asdfgh0318/RadioMicroscope/1.md

# Original Prompt — RadioMicroscope v2

> redo this thing from scratch wih next gen in mind be able to source parts from poland and achieve great allaround featurres move everything to archive use 1.md research repo first

Saved verbatim, 2026-11-11. The v1 prototype this refers to is in [`archive/v1/`](archive/v1/).
