asdfgh0318/RadioMicroscope/papers/antennas/D_3ds_cst_learning_edition.md

# CST STUDIO SUITE Learning Edition

**Complete Technology for 3D Electromagnetics**

## The CST Studio Suite Learning Edition is available free of charge to students, educators and researchers of personal and educational use

The CST Studio Suite Learning Edition introduces you to the world of electromagnetic simulation, making Maxwell’s equations easier to understand than ever. With this free edition you have - bar some restrictions - access to our powerful visualization engine and some of the most advanced solvers of CST Studio Suite, making it ideal for use as part of coursework as well as for anyone wishing to become more proficient with CST Studio Suite. You can download the CST Studio Suite Learning Edition free of charge from the SIMULIA Community.

### **Join the SIMULIA Community,** it's free!

[](/media/9399)

[   https://youtu.be/Z0qi5\_Alm8c
 1 minute     ](https://youtu.be/Z0qi5_Alm8c)

Simply log in with your 3DEXPERIENCE ID username and password. If you do not already have a 3DEXPERIENCE ID, you can register now . An account is free and access is instant.

The SIMULIA Community is our user forum for all those interested in simulation of structures, fluids or electromagnetic fields. You can discuss simulation with your peers, find the latest resources on SIMULIA simulation technology, get insights from experts and select from a large range of e-seminars to deepen your knowledge.

To accompany the CST Studio Suite Learning Edition, we have prepared some examples, which are typical of the type of textbook problems you may encounter during your studies of electromagnetic theory or other related courses. Each tutorial includes descriptive text, a CST Studio Suite file, and also a short video showing how to construct each of the models. These examples are available in the SIMULIA Community.

 CST Tutorials> Dassault Systèmes (https://www.3ds.com/assets/invest/2023-03/edu-cst-tutorials.jpg)

## CST Studio Suite Tutorials

\<!--td {border: 1px solid #cccccc;}br {mso-data-placement:same-cell;}-->
\<!--td {border: 1px solid #cccccc;}br {mso-data-placement:same-cell;}-->
\<!--td {border: 1px solid #cccccc;}br {mso-data-placement:same-cell;}-->
To get started, CST Studio Suite Tutorials are available here

[Discover](https://r1132100503382-eu1-3dswym.3dexperience.3ds.com/#community:39/wiki:13_mFrlJTnmMB6fVWqzDkw)

 CST Installation> Dassault Systèmes (https://www.3ds.com/assets/invest/2023-03/edu-cst-install.jpg)

## CST Studio Suite Install instructions

\<!--td {border: 1px solid #cccccc;}br {mso-data-placement:same-cell;}-->
\<!--td {border: 1px solid #cccccc;}br {mso-data-placement:same-cell;}-->
CST Studio Suite Learning Edition Installation Instructions

[Download](https://r1132100503382-eu1-3dswym.3dexperience.3ds.com/#community:39/media:Cq90wV9kR2adsF6Hak7Wpw)

## System requirements

CST Studio Suite is available for modern Windows operating systems. Please refer to the installation guide for more information.

## Download Issues

For download and installations issues only (no support for CST Studio Suite), please use the **[community](https://r1132100503382-eu1-3dswym.3dexperience.3ds.com/#community:39)** to contact us

## OTHER SOLUTIONS AVAILABLE

Discover our full panel of solutions available, the choice is yours!
*Login can be required for some solutions.*

## SOLIDWORKS xDesign for Students

100% cloud design and engineering apps to upskill and land your dream job – From any device.

[Edu-SW-Cloudapps-stu](/media/8403)

[Learn more](/edu/education/students/solutions/solidworks-3dx)

STUDENT OFFER

## CATIA Mechanical for Students

Take your design, engineering &amp; sophisticated mechanical projects to the next level!

[Edu-3DX-Catia-stu-576x488](/media/8681)

[Learn more](/edu/education/students/solutions/catia-3dx)

STUDENT OFFER

## 3DEXPERIENCE ENGINEER for Students

The most complete and advanced design-to-manufacture package.

[Edu-3DX-Engineer-stu-576x488](/media/8682)

[Learn more](/edu/education/students/solutions/engineer-3dx)

STUDENT OFFER

## Abaqus Learning Edition

Complete solution for realistic simulation.
Available free of charge for personal and educational use.

[Edu-leg-Abaqus-stu-424x500](/media/8683)

[Discover](/edu/education/students/solutions/abaqus-le)

LEARNING EDITION

## CST Studio Suite Learning Edition

Complete Technology for 3D Electromagnetics.
Available free of charge for personal and educational use.

[Edu-leg-CST-stu-424x500](/media/8685)

[Discover](/edu/education/students/solutions/cst-le)

LEARNING EDITION

## Antenna Magus Learning Edition

The Leading Antenna Design Tool.
Available free of charge for personal and educational use.

[Edu-leg-Antenna-stu-424x500](/media/8684)

[Discover](/edu/education/students/solutions/antenna-magus-le)

LEARNING EDITION

## ICEM Surf Learning Edition

The Art of Surface Modelling
Free download

[Edu ICEM Surf Learning Edition solution](/media/18276)

[Discover](/edu/education/students/solutions/icem-surf)

LEARNING EDITION

## SOLIDWORKS Desktop

Proven and Powerful SOLIDWORKS 3D CAD, **available for free**

[Edu Solidworks desktop solution student ](/media/22171)

[Discover](https://www.solidworks.com/product/students/design-standard-form)

STUDENT EDITION

## HomeByMe

Free and easy-to-use online software to design and decorate your home in 3D.

[Edu-leg-Homebyme-stu-424x500](/media/8686)

[Discover](https://home.by.me/)

FREE ONLINE

 CST Studio Suite LE hero banner> Dassault Systèmes

[  Download for free     ](https://r1132100503382-eu1-3dswym.3dexperience.3ds.com/#community:39/wiki:_NXifU43Q7yHzTiCX9yEaw)

Solutions
