asdfgh0318/RadioMicroscope/papers/antennas/D_gh_ICDT-Inatel-Cubesat-Design-Team_S-Band-Antenna_README.md

<div align="center">
  ICDT Logo
</div>
<h1 align="center">S-Band RHCP 2.45 GHz Antenna</h1>

<p align="center">
    
    
    
    
    
</p>

<p align="center">
    <a href="#overview">Overview</a> •
    <a href="#repository-organization">Repository Organization</a> •
    <a href="#releases">Releases</a> •
    <a href="#references">References</a> •
    <a href="#license">License</a>
</p>

## Overview
This project involves the development of an S-band antenna tailored for a 1U CubeSat platform. The system is engineered to handle both uplink and downlink capabilities using LoRa technology, specifically optimized for integration with the E80-900M2213S module.

<p align="center">
    &nbsp;&nbsp;&nbsp;
</p>

**Technical Parameters**
- Center Frequency: 2.45 GHz
- Axial Ratio Bandwidth: 14 MHz (2443 – 2457 MHz for AR < 3 dB)
- Peak Realized Gain: 7.58 dBi
- Polarization: Right-Hand Circular Polarization (RHCP)
- Connector Type: Right-Angle SMA

## Repository Organization

* `docs`: Technical documentation and datasheets.
* `hardware`: Core hardware files.
    * `3D`: 3D models (.step).
    * `Fabrication`: BOM and Gerber files for JLCPCB manufacturing.
    * `PCB`: KiCad schematics and layout design.
* `simulation`: Ansys HFSS simulation and data files.

## Releases

<table>
  <thead>
    <tr>
      <th>Render</th>
      <th>Board Name</th>
      <th>Status</th>
      <th>Latest Release</th>
      <th>Date</th>
      <th>Datasheet</th>
      <th>BOM</th>
      <th>Ordering Info</th>
    </tr>
  </thead>
  <tbody>
    <tr>
      <td>render</td>
      <td>S-Band Antenna v1</td>
      <td>🧪 Testing</td>
      <td><a href="https://github.com/ICDT-Inatel-Cubesat-Design-Team/S-Band-Antenna/releases/tag/v1.0">v1.0</a></td>
      <td>05-06-2026</td>
      <td><a href="docs/Datasheet S-Band RHCP 2.45 GHz Antenna.pdf">PDF</a></td>
      <td>Yes</td>
      <td><a href="hardware/Fabrication/GERBER-Antenna.zip">GERBER</a> (JLCPCB)</td>
    </tr>
  </tbody>
</table>

## References

This project was based on the SpaceLab UFSC [S-Band Antenna Project](https://github.com/spacelab-ufsc/sband-antenna/), with special thanks to [Lucas Ryan](https://github.com/SPHINXLRC) (SpaceLab) and [Yunior Alcantara](https://github.com/yag0x1) (SpaceLab) for their assistance with the SMA connectors.

**Missions Associated with this Project**

<p>
  
  
  
<p>

## License

This project is licensed under the permissive, weakly-reciprocal **[CERN-OHL-W-2.0](LICENSE)** open-hardware license. You are free to modify and distribute these files, provided downstream hardware design modifications remain under the same terms.
