asdfgh0318/RadioMicroscope/papers/antennas/EXTRACTS.md

# EXTRACTS — antenna research for the radio microscope (merged A + B + C + D)

Merged 2026-11-11 from `_EXTRACTS_A.md` (beam theory, sampling, polarisation, calibration, rotary joints),
`_EXTRACTS_B.md` (DIY designs, RF switches), `_EXTRACTS_C.md` (ready-made antennas, prices, pigtails) and
`_EXTRACTS_D.md` (PCB fab cost, FR4 loss, open designs, simulators, cable/connector losses). The part files are
left in place and are the authoritative copies; this file is their concatenation, unchanged except for this
header and the quote-check record at the end. Every quote is verbatim from a file saved in this folder.
Evidence tags: [V] read at source in the saved file; [S] search snippet only (no claim rests on it).

<!-- ===================== part A (from _EXTRACTS_A.md) ===================== -->

# Extracts, part A: beam theory for a mapper, calibration, rotary joints

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

---

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

---

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

<!-- ===================== part B (from _EXTRACTS_B.md) ===================== -->

# Extracts — fork B (Q2 DIY designs, Q3 dual-band / RF switch)

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

---

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

> "The gain at 2400.000 MHz was recorded at 7.22 dBi." (p.6, §4.2)

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

---

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

---

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

---

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

---

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

---

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

---

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

---

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

---

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

---

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

<!-- ===================== part C (from _EXTRACTS_C.md) ===================== -->

# Extracts C: ready-made lightweight directional antennas (question 4)

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

---

## 5.8 GHz, circular polarisation (FPV)

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

## 5.8 GHz, linear polarisation

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

## 2.4 GHz

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

## Dual-band 2.4 + 5 GHz

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

## Pigtails (U.FL / IPEX-1 to SMA / RP-SMA), Poland

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

---

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

<!-- ===================== part D (from _EXTRACTS_D.md) ===================== -->

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

---

## D-1. PCB fabrication cost and delivery to Poland

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

---

## D-2. FR4 dielectric loss and what it costs in gain

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

---

## D-3. Open antenna designs with a licence

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

---

## D-4. Free simulators

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

---

## D-5. Feed cable and connector losses (closes the part-D gap and task 2)

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

---

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

---

## Quote-check record (2026-11-11)
40 quotes from parts A, B and C (about 13 per part, including prices read from JSON-LD) were re-checked against
the saved .txt/.html files with whitespace-normalised string search. All 40 match in substance. Differences found
are layout artefacts only: pdftotext line/column breaks (A4 Ford, A6 Mangum, A13 Wunderlich p.59, B15 QEX helix,
B16 Radioeng), the "observaAons" ligature already noted in A4, and a curly apostrophe ("shouldn’t") printed
straight in A6. No quote was found that changes a number or the meaning of its source.
Quotes written for part D were checked the same way (41 checked; one capitalisation slip, "Near-Field", corrected).
