asdfgh0318/RadioMicroscope/papers/extra-sensors/EXTRACTS.md

# EXTRACTS - extra sensors (2026-11-11)

Quotes are verbatim (whitespace-collapsed) from the saved local files; checked programmatically.

## Hi-Link HLK-LD2450 manual (via elemon mirror) https://www.elemon.com.ar/images/productos/hojas-de-datos/radar-modulos/hlk-ld2450.pdf
Local file: `ld2450.pdf`

- "Precise motion target localization and tracking"
- "Longest detection range 6m"
- "Azimuth angle ±60°, pitch angle ±35°"
- "256000, with 1 stop bit and no parity bit."
- "Ultra-small module size: 15mm x 44mm"

## ST VL53L5CX datasheet https://cdn.sparkfun.com/assets/6/e/3/0/6/vl53l5cx-datasheet.pdf
Local file: `vl53l5cx.pdf`

- "Time-of-Flight 8x8 multizone ranging sensor with wide field of view"
- "Up to 400 cm ranging"
- "I2C: 400 kHz to 1 MHz serial bus, address: 0x52"

## Melexis MLX90640 datasheet https://www.melexis.com/-/media/files/documents/datasheets/mlx90640-datasheet-melexis.pdf
Local file: `mlx90640.pdf`

- "Small size, low cost 32x24 pixels IR array"
- "2 FOV options – 55°x35° and 110°x75°"
- "Programmable refresh rate 0.5Hz…64Hz"

## Panasonic Grid-EYE AMG88 spec (Adafruit mirror)
Local file: `amg8833.pdf`

- "Pixel number 64（8×8 Matrix）"
- "Typ.60°（Horizontal, Vertical)"

## ESPHome LD2410 page https://esphome.io/components/sensor/ld2410/
Local file: `esphome_ld2410.html`

- "The ld2410 sensor platform allows you to use HI-LINK LD2410 motion and presence sensors with ESPHome."

## ESPHome LD2450 page https://esphome.io/components/sensor/ld2450/
Local file: `esphome_ld2450.html`

- "enabling measurement of the target’s distance, angle and speed (relative to the sensor)"

## Botland TF-Luna 99,00 PLN InStock https://botland.com.pl/czujniki-time-of-flight/16638-laserowy-czujnik-odleglosci-lidar-tf-luna-8m-uarti2c-5903351249041.html
Local file: `botland_tfluna.html`

- "Komunikacja: UART / I2C"
- "Zakres pracy: od 0,2 m do 8 m (współczynnik odbicia 90%)"
- "Kąt widzenia FoV: 2°"
- "Częstotliwość: 100 Hz"

## Botland Seeed Human Static Presence 24GHz 24,90 PLN InStock (page id 24129)
Local file: `botland_seeed_mr24.html`

- "Interfejs: GPIO (poziom IO 3,3 V), UART"
- "Zasięg wykrywania: od 0,75 m do 6 m (regulowany)"

## Botland DFRobot C4001 59,90 PLN InStock (id 25320)
Local file: `botland_c4001.html`

- "zapewniający zasięg do 12 metrów"
- "Obsługuje interfejs Gravity oraz komunikację I2C i UART"
- "Pomiar prędkości : umożliwia detekcję prędkości od 0,1 m/s do 10 m/s"

## msalamon HLK-LD2410B 33,19 PLN, 21 in stock https://sklep.msalamon.pl/produkt/hlk-ld2410b-czujnik-obecnosci-czlowieka-24ghz/ (LD2410C 28,09 PLN page shows OutOfStock)
Local file: `msal_ld2410b.html`

- "maksymalnym zasięgu wykrywania do 6 metrów"
- "Napięcie zasilania wynosi 5V"

## msalamon CDM324 28,99 PLN InStock
Local file: `msal_cdm324.html`

- "Radar Dopplera CDM324"

## Botland reSpeaker XVF3800 269,00 PLN OutOfStock (id 28171)
Local file: `botland_xvf3800.html`

- "umożliwia precyzyjne wykrywanie kierunku źródła dźwięku (DoA)"

## Seeed XVF3800 wiki https://wiki.seeedstudio.com/respeaker_xvf3800_introduction/
Local file: `xvf3800_wiki.html`

- "featuring AEC, AGC, DoA, beamforming"

## Botland M5Stamp ESP32-P4 63,90 PLN InStock (id 28729)
Local file: `botland_p4stamp.html`

- "interfejsy MIPI CSI i MIPI DSI"

## Espressif ESP32-P4 datasheet https://www.espressif.com/sites/default/files/documentation/esp32-p4_datasheet_en.pdf
Local file: `esp32p4_datasheet.pdf`

- "– MIPI CSI"

## espressif/esp32-camera README (raw.githubusercontent)
Local file: `esp32cam_readme.md`

- "### Autofocus (OV5640)"
- "OV5640 autofocus relies on loading an internal firmware blob over SCCB during `esp_camera_af_init()`."

## Botland Grove AS3935 139,00 PLN InStock (id 23887)
Local file: `botland_as3935.html`

- "w promieniu do 40 km"
- "Komunikuje się za pośrednictwem interfejsu I2C lub SPI"

## Botland M5Stack GPS/BDS Unit AT6668 61,90 PLN InStock (id 26079)
Local file: `botland_m5_gps_at6668.html`

- "Częstotliwość aktualizacji pozycji: do 10 Hz"
- "Interfejs komunikacyjny: UART (115200 bps przy 8N1)"

## Botland Waveshare Thermal Camera HAT 80x62 389,00 PLN InStock (id 23877)
Local file: `botland_thermal_hat_waveshare.html`

- "80x62px, 45 FOV"
- "maksymalnej szybkości 25 klatek na sekundę (FPS)"

## Seeed XIAO ESP32-S3 wiki https://wiki.seeedstudio.com/xiao_esp32s3_getting_started/
Local file: `xiao_s3_wiki.html`

- "D4 Analog, SDA GPIO5"
- "D6 TX GPIO43 GPIO, UART Transmit"
- "Digital microphone_CLK GPIO42 PDM clock pin for MIC"
- "Onboard SD Card_SCK GPIO7"

## CNX Software 2026-10-04 ESP-SDR article (saved earlier in papers/sdr)
Local file: `cnx-esp-sdr.txt (in ../sdr)`

- "Supported chips – ESP32, ESP32-C3, ESP32-C5 (dual-band 2.4/5 GHz)"
- "ESP-WebSDR captures short I/Q snapshots to build the spectrum and waterfall"
- "The original ESPARGOS firmware remains receive-only."

## Prices read from product page data (PLN gross; shop; stock as page shows)
- Botland: VL53L5CX Pololu 3417 69,90 OutOfStock; VL53L7CX Pololu 3418 89,90; VL53L5CX SparkFun SEN-19013 149,90 InStock; VL53L1X Pololu 81,90 InStock; M5 ToF4M VL53L1X 52,90 InStock; TF-Luna 99,00 InStock; TFmini-S 199,00 InStock; TFmini Plus 219,00 (list); LD19 DTOF 360 DFRobot SEN0547 599,00 InStock
- Botland thermal: MLX90641 16x12 Waveshare 249,00 OutOfStock; Waveshare Thermal HAT 80x62 389,00; M5Stick T-Lite (MLX90640) 439,00 InStock; UNI-T UTi260B 256x192 1299,00 InStock. Adafruit MLX90640 4469 on botland.store 'temporarily unavailable' (EUR, not PLN).
- Botland radar: S3KM1110 Waveshare 12,90 OutOfStock; Seeed Human Static Presence 24,90 InStock; DFRobot C4001 59,90 InStock; DFRobot SEN0395 142,00; Grove BGT24LTR11 349,00
- msalamon: HLK-LD2410B 33,19 InStock (21 pcs); HLK-LD2410C 28,09 OutOfStock; CDM324 28,99 InStock; ESP32-CAM 42,69 InStock; ATGM336H GPS 32,59 InStock; INMP441 37,19 InStock; ESP32-S3-EYE 358,19
- Gotronik: INMP441 12,00 (itemprop price; ships 24 h)
- Botland audio/cam: ICS43434 Adafruit 47,90 InStock; SPH0645 39,80; XVF3800 269,00 OutOfStock; ReSpeaker Mic Array v2.0 259,00; XIAO ESP32-S3 Sense 79,90 OutOfStock; DFR1154 ESP32-S3 OV3660 109,00 InStock; M5 CamS3 5MPx 89,90 InStock; ESP32-CAM Joy-IT 54,90; M5Stamp ESP32-P4 63,90 InStock; ESP32-P4-Function-EV 439,00 OutOfStock
- Botland other: QMC5883L GY-271 29,90 InStock; MMC5603 Adafruit 31,90; BMM150 Waveshare 27,90; AS7341 Waveshare 75,90; Grove AS3935 139,00; Geiger DFRobot 289,00 / Joy-it 299,00; LC29H L1+L5 GNSS HAT 199,00; M5 GPS AT6668 61,90

## Could not retrieve / not verified
- LD2450, MLX90640 (bare), AMG8833, RD-03D/E, LD2420, LD2461, MR60BHA2, BGT60, HLK-LD2450 PLN price: no Polish shop page found/opened (kamami.pl/tme.eu return 403) - no PLN price claimed.
- TF-Luna, TFmini-S, LD19, INMP441, ICS43434, AS3935, QMC5883L, RM3100, MMC5983MA, OV5640 module, Waveshare S3KM1110 manuals: only shop/vendor page text (not datasheet PDFs) read. Shop-page specs, tier [S]/shop.
- GNSS raw data (UBX RAWX) on ATGM336H/AT6668: not verified.
- InfiRay P2, Topdon TC001, HTPA, Infineon BGT60, Seeed MR60BHA2: not researched.
