asdfgh0318/RadioMicroscope/docs/notes-1.jpeg

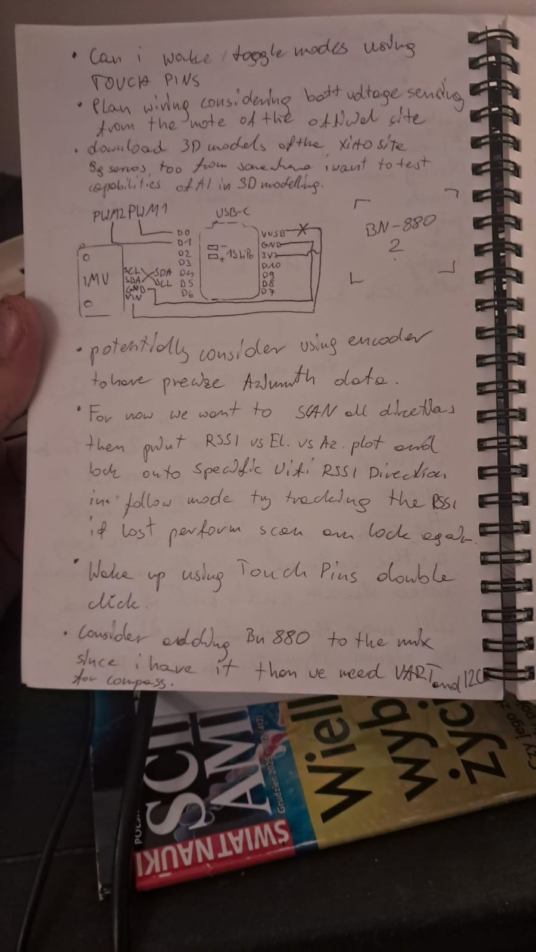
docs/notes-1.jpeg
