asdfgh0318/RadioMicroscope/docs/notes-2.jpeg

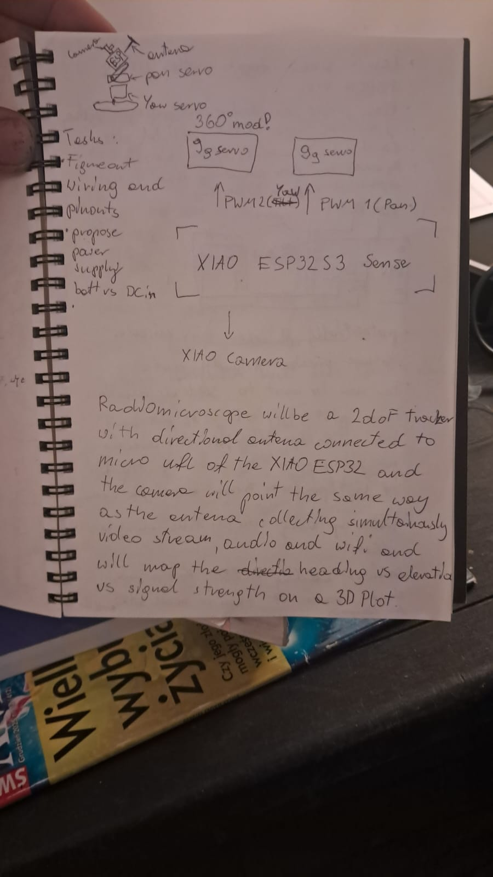
docs/notes-2.jpeg
