asdfgh0318/RadioMicroscope/docs/prototype.jpeg

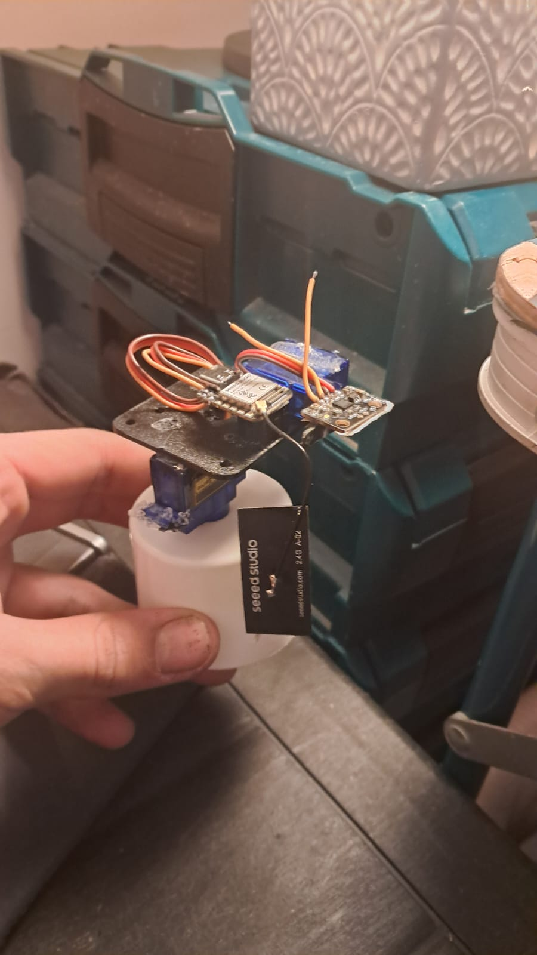
docs/prototype.jpeg
