asdfgh0318/RadioMicroscope/docs/sourcing.md

# Polish sourcing: listings checked on 2026-11-11

Raw results of the shop checks behind the parts list. Prices are gross PLN as shown on the day.

**How to read the "checked" column**

- **page** — the shop's own product page was opened and the price and stock read from it.
- **listing** — the shop's own search/category listing was read, not the product page.
- **snippet** — seen only through a search snippet or a price aggregator (elecena.pl, Ceneo). Treat price and stock as unconfirmed.
- **maker** — manufacturer's page with a recommended price; no shop found.

Kamami and Allegro refused automated access (HTTP 403), so nothing from them is better than "snippet". TME opened only partly. Batna24, Wispro, ElectroPark and Nettigo could not be searched.

## Motion

| Item | Shop | PLN | Stock on the day | Checked |
|---|---|---|---|---|
| Waveshare ST3215 bus servo, 30 kg·cm, 12-bit magnetic encoder, 6–12.6 V | [Botland](https://botland.com.pl/serwa-praca-ciagla-360/21963-30kg-serial-bus-servo-serwomechanizm-z-enkoderem-magnetycznym-360-stopni-waveshare-22414.html) | 109.00 | none; 86 due 20.11.2026 | page |
| Waveshare ST3215-HS, 20 kg·cm, 106 rpm, same bus | [Botland](https://botland.com.pl/serwa-praca-ciagla-360/23725-20kg-bus-servo-motor-serwomechanizm-z-enkoderem-magnetycznym-360-stopni-waveshare-25127.html) | 105.00 | 38 | page |
| Waveshare ST3020, 25 kg·cm | [Botland](https://botland.com.pl/serwa-praca-ciagla-360/23726-st3020-25kg-serial-bus-servo-serwomechanizm-uart-waveshare-24703.html) | 115.00 | 17 | page |
| Waveshare SC09, 2.3 kg·cm, potentiometer 1024 steps, 300° | [Botland](https://botland.com.pl/serwa-praca-ciagla-360/23561-sc09-23kg-serial-bus-servo-serwomechanizm-uart-waveshare-24440.html) | 45.90 | none; 100 due 18.12.2026 | page |
| Waveshare ST3215 7.4 V version | Kamami | 93.33 | unknown | snippet |
| Bus Servo Adapter (A), UART + USB-C | [Botland](https://botland.com.pl/sterowniki-serw/24907-bus-servo-adapter-a-sterownik-do-serwomechanizmow-magistrali-szeregowej-serii-stsc-uart-waveshare-25514-5904422385736.ht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) | 19.90 | none; 48 due 04.12.2026 | page |
| Bus Servo Adapter (A) | Kamami | ~21.17 | unknown | snippet |
| Waveshare Servo Driver with ESP32 | [Botland](https://botland.com.pl/sterowniki-serw/21964-esp32-servo-driver-expansion-board-sterownik-do-serwomechanizmow-uart-wifi-bluetooth-waveshare-21593.html) | 69.90 | 9 | page |
| Waveshare 2-axis pan-tilt camera module (ST3215, pan ±180°, tilt −45…+90°) | Kamami | 531.62 | unknown | snippet |
| Slip ring 6 wires × 2 A, 22 mm, 300 rpm | [Botland](https://botland.com.pl/zlacza-slizgowe/7143-pierscien-slizgowy-6-przewodowy-2a-22mm-5904422335533.html) | 67.00 | 41 | page |
| Slip ring 12 wires × 2 A, 22 mm | [Botland](https://botland.com.pl/zlacza-slizgowe/7145-pierscien-slizgowy-12-przewodowy-2a-22mm-5904422335540.html) | 84.90 | 36 | page |
| NEMA17 JK42HS40-1704, 0.4 N·m | [Botland](https://botland.com.pl/silniki-krokowe/6429-silnik-krokowy-jk42hs40-1704-200-krokowobr-28v17a04nm-5904422334635.html) | 69.00 | 29 | page |
| TMC2209 driver (BigTreeTech v1.3) | [Botland](https://botland.com.pl/stepstick-sterowniki-do-silnikow-krokowych/19883-sterownik-silnika-krokowego-bigtreetech-tmc2209-v13-5904422379667.html) | 27.90 | 200 | page |
| TMC2209 stepstick | [MSX](https://sklep.msalamon.pl/produkt/sterownik-silnika-krokowego-tmc2209/) | 21.79 | 28 | page |
| AS5600 12-bit magnetic encoder with magnet | [MSX](https://sklep.msalamon.pl/produkt/as5600-enkoder-magnetyczny-12-bit/) | 11.19 | 76 | page |
| Steel turntable bearing 155 × 155 mm | [ABC-RC](https://abc-rc.pl/pl/products/obrotnica-meblowa-obrot-360-155x155mm-lozysko-obrotowe-fotela-stolu-21908.html) | 18.20 | yes | page |

Notes: Botland's ST3215 page gives no baud rate and a wrong weight (the Kamami snippet says 69 g). Stall current is 2.7 A (ST3215) and 2.4 A (ST3215-HS) per the pages. No slip ring with a through-bore was found at retail.

## Brushless direct drive

| Item | Shop | PLN | Stock on the day | Checked |
|---|---|---|---|---|
| SimpleFOC Mini driver (DRV8313), 8–30 V, 2.5 A per channel, 3.3 or 5 V logic (page re-read later the same day) | [Gotronik](https://www.gotronik.pl/modul-sterownika-silnika-simplefoc-mini-na-ukladziedrv8313-p-14252.html) | 25.00 | in stock | page |
| SimpleFOCMini DRV8313, 8–30 V, 2.5 A | [Gotronik](https://www.gotronik.pl/modul-sterownika-silnika-bezszczotkowego-dc-simplefocmini-foc-drv8313-p-12826.html) | 36.00 | out of stock | page |
| Dual-channel DRV8313 driver | [Gotronik](https://www.gotronik.pl/modul-dwukanalowego-sterownika-silnika-bezszczotkowego-bldc-drv8313-p-12830.html) | 47.00 | out of stock | page |
| ESP32 FOC 20 A board | [Gotronik](https://www.gotronik.pl/modul-sterownika-silnika-bezszczotkowego-esp32-foc-20a-wifi-bluetooth-p-12828.html) | 99.00 | in stock | page |
| Makerbase MKS ESP32 FOC, dual channel | Kamami | 149.90 | unclear | snippet |
| AS5600 encoder with magnet | [MSX](https://sklep.msalamon.pl/produkt/as5600-enkoder-magnetyczny-12-bit/) | 11.19 | 76 | page |
| MT6701 encoder, 14-bit, magnet included | [MSX](https://sklep.msalamon.pl/produkt/mt6701-magnetyczny-enkoder/) | 15.19 | out of stock | page |
| Gimbal motor, no-name 2208 80T / 90 KV | Allegro | ~64–86 | unknown | snippet |
| T-Motor GB2208 | Allegro (archived listing) | ~99.86 | unknown | snippet |
| M5Stack RollerCAN: motor + FOC driver + encoder + slip ring in one, 0.065 N·m at 16 V, 84 g | [Botland](https://botland.com.pl/moduly-unit-moduly-rozszerzen/26016-rollercan-unit-silnik-bezszczotkowy-ze-sterownikiem-stm32-modul-rozszerzen-unit-m5stack-u188-6972934175687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) | 239.00 | in stock | page |
| M5Stack Roller485 (same, RS-485) | [Botland](https://botland.com.pl/moduly-unit-moduly-rozszerzen/26021-roller485-unit-silnik-bezszczotkowy-ze-sterownikiem-stm32-modul-rozszerzen-unit-m5stack-u182-6972934175533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) | 229.00 | in stock | listing |

Notes: no dedicated gimbal motor (iPower GM/GBM, T-Motor GB) was found at any Polish shop whose pages opened; the only sightings are Allegro marketplace snippets. No BaseCam or Storm32 gimbal controller and no AS5048A breakout were found at a regular shop.

## Controllers, radios and sensors

| Item | Shop | PLN | Stock on the day | Checked |
|---|---|---|---|---|
| Seeed XIAO ESP32-C5: 2.4 + 5 GHz Wi-Fi 6, U.FL socket, 8 MB flash, 8 MB PSRAM | [Botland](https://botland.com.pl/xiao/28890-seeed-xiao-esp32-c5-wifibluetoothzigbeethreadmatter-seeedstudio-100010048-5902186335752.html) | 30.90 | orderable; no further delivery planned | page |
| Seeed XIAO ESP32-S3 Sense (camera, microphone, microSD) | [Botland](https://botland.com.pl/xiao/22926-seeed-xiao-esp32-s3-sense-zestaw-z-kamera-ov3660-wifibluetooth-seeedstudio-113991115.html) | 79.90 | none; about 31.12.2026 | page |
| Seeed XIAO ESP32-S3 (no camera) | [Botland](https://botland.com.pl/xiao/22878-seeed-xiao-esp32-s3-wifibluetooth-seeedstudio-113991114.html) | 37.90 | orderable | listing |
| XIAO ESP32-S3 + Wio-SX1262 LoRa kit (862–930 MHz) | [Botland](https://botland.com.pl/xiao/25675-zestaw-xiao-esp32-s3-wio-sx1262-do-meshtastic-i-loralorawan-seeedstudio-102010611-4897068320128.html) | 59.90 | orderable | page |
| Adafruit BNO085 9-axis orientation sensor | [Botland](https://botland.com.pl/czujniki-9dof-imu/22113-bno085-9-dof-imu-fusion-breakout-3-osiowy-akcelerometr-zyroskop-i-magnetometr-adafruit-4754.html) | 139.00 | orderable | page |
| Arduino Modulino Movement (LSM6DSOX, 6-axis) | [Botland](https://botland.com.pl/arduino-modulino/26942-arduino-modulino-movement-6-osiowy-imu-akcelerometr-i-zyroskop-lsm6dsoxtr-qwiic-abx00101-7630049205314.html) | 57.90 | orderable | listing |
| GY-271 magnetometer (QMC5883L; some ship with HMC5883L) | [Botland](https://botland.com.pl/magnetometry/2722-magnetometr-gy-271-3-osiowy-cyfrowy-i2c-33v-5v-qmc5883l-5903351249621.html) | 29.90 | shown available | page |
| Seeed L76K GNSS module for XIAO, with antenna | [Botland](https://botland.com.pl/moduly-gps/25377-modul-pozycjonowania-multi-gnss-do-seeed-xiao-l76k-gps-beidou-glonass-qzss-seeedstudio-109100021-5904422386610.html) | 75.90 | orderable | page |
| BN-880 GPS + compass (HMC5883L, UART default 38400 per the shop) | [nobshop](https://www.nobshop.pl/modul-gps-z-kompasem-bn-880-p-1485.html) | 99.00 | unavailable | page |
| RTL-SDR V3 | [sapsan](https://sapsan-sklep.pl/products/rtl-sdr-v3-r820t2-rtl2832u) | 258.00 | not shown | listing |
| Raspberry Pi Zero 2 W | [Botland](https://botland.com.pl/moduly-i-zestawy-raspberry-pi-zero/20347-raspberry-pi-zero-2-w-512mb-ram-wifi-bt-42-5056561800004.html) | 72.90 | none; about 04.01.2027 | listing |
| OLED 0.96" 128 × 64 I2C | [Botland](https://botland.com.pl/wyswietlacze-i-ekrany/8866-wyswietlacz-oled-niebieski-graficzny-096-128x64px-i2c-niebieski-5904422337421.html) | 14.90 | orderable | listing |

Notes: the XIAO ESP32-C5 is the only ESP32-C5 board with an external-antenna socket that was confirmed orderable in Poland; it ships with a 2.4 GHz flex antenna only. Seeed asks for esp32 board package 3.3.5 or newer for it. No AD8317/AD8318 power-detector module and no RTL-SDR Blog V4 were found at any Polish shop checked.

## Antennas

| Item | Gain | Beamwidth H / V | Weight | Shop | PLN | Checked |
|---|---|---|---|---|---|---|
| ATK-P1 2.4 GHz panel, 120 × 120 × 20 mm, 3 m cable, RP-SMA plug | 8 dBi | 70° / 70° | 300 g | [Dipol](https://www.dipol.com.pl/antena_mikropaskowa_panelowa_atk-p1-2_4_ghz_3_m_przewodu_wtyk_sma_r-p_8_dbi_A7132.htm) | 90.53, available | page |
| Yagi 2.4 GHz, 245 mm long, 1 m cable, RP-SMA plug | 12 dBi | 35° / 30° | 400 g | [Cyberbajt](https://www.cyberbajt.pl/produkt/2833/yagi-12dbi-1m-rp-sma.html) | 84.87 | page |
| Yagi 2.4 GHz, 520 mm long | 16 dBi | 30° / 24° | 500 g | [Cyberbajt](https://www.cyberbajt.pl/produkt/2826/yagi-16dbi-1m-rp-sma.html) | 92.25 | page |
| AntenaBox v2 16, 2.4 GHz panel in an enclosure, 194 × 179 × 78 mm, RP-SMA plug | 16 dBi | 28° / 23° | 357 g | [Cyberbajt](https://www.cyberbajt.pl/produkt/5035/antenabox-v2-16-rp-sma.html) | 105.78 | page |
| GigaEter 13, 5.45–5.75 GHz panel, 140 × 123 × 17 mm, N socket | 13 dBi | 33° / 33° | 128 g | [Cyberbajt](https://www.cyberbajt.pl/produkt/1521/gigaeter-13.html) | 84.87 | page |
| AntenaBox v2 19, 4.9–6.0 GHz, U.FL | 18–19 dBi | 18° / 18° | 335 g | [Cyberbajt](https://www.cyberbajt.pl/produkt/5036/antenabox-v2-19-ufl.html) | 88.56 | page |
| Interline PANEL 8 DUAL-BAND, 115 × 115 × 18 mm | 8 / 12 dBi | 40° / 40° at 2.4; 36° / 25° at 5 | 380 g with mount | [Interline](https://interline.pl/antennas/PANEL-8-DUAL-BAND) | €33 net RRP | maker |
| Delock 88904 dual-band directional, RP-SMA | 10 dBi max | not stated | not stated | SuperTech via [Ceneo](https://www.ceneo.pl/45258472) | 164.99 | snippet |
| ZeenKo ZA-048 log-periodic PCB, 400 MHz–8 GHz, 270 × 230 mm | not stated | not stated | not stated | [Gotronik](https://www.gotronik.pl/za-048-szerokopasmowa-antena-drukowana-ldpa-400mhz-8ghz-zeenko-p-14648.html) | 145.00, ships in 24 h | page |
| Interline Panel 8, 868 MHz, 223 × 223 mm | 8 dBi | 70° / 60° | 650 g with mount | [Interline](https://interline.pl/antennas/Panel-8-868-MHz-LoRaWAN-Directional) | €48 net RRP | maker |

Notes: Cyberbajt pages show a price and an add-to-cart button but no stock figure. No small dual-band panel was found on a Polish shop's own page with stock. No 2.4 GHz PCB Yagi and no light 868 MHz directional antenna were found.

## RF cables

| Item | Shop | PLN | Stock | Checked |
|---|---|---|---|---|
| U.FL → RP-SMA socket, 200 mm | [ABC-RC](https://abc-rc.pl/pl/products/przejscie-u-fl-ipex-na-rp-sma-jack-adapter-prosty-z-przewodem-200mm-20555.html) | 4.68 | 183 | page |
| U.FL → RP-SMA socket, 100 mm | [ABC-RC](https://abc-rc.pl/pl/products/przejscie-u-fl-ipex-na-rp-sma-jack-adapter-prosty-z-przewodem-100mm-9839.html) | 4.50 | 32 | page |
| U.FL → SMA socket, 200 mm | [ABC-RC](https://abc-rc.pl/pl/products/przejscie-u-fl-ipex-na-sma-jack-adapter-prosty-z-przewodem-200mm-9838.html) | 7.32 | 432 | page |
| U.FL → RP-SMA, 15 cm (SparkFun WRL-18569) | [Botland](https://botland.com.pl/anteny/1609-przejsciowka-meska-rp-sma-ufl-15cm-sparkfun-wrl-18569-5904422369934.html) | 15.90 | 60 | page |

## Power

| Item | Shop | PLN | Stock | Checked |
|---|---|---|---|---|
| USB-C PD trigger, fixed 12 V, up to 5 A | [MSX](https://sklep.msalamon.pl/produkt/modul-wyzwalacza-szybkiego-ladowania-usb-c-12v-5a-pd/) | 5.29 | 16 | page |
| USB-C PD trigger, 9/12/15/20 V by solder jumper, 5 A | [Gotronik](https://www.gotronik.pl/modul-wyzwalacza-napiecia-usb-c-pd-qc-5a-p-14408.html) | 9.00 | ships in 24 h | page |
| USB-C PD trigger, 5–20 V by DIP switch | [Gotronik](https://www.gotronik.pl/wyzwalacza-szybkiego-ladowania-pd-usb-c-p-13295.html) | 12.00 | ships in 24 h | page |
| MP1584EN step-down, fixed 5 V, 3 A max | [ABC-RC](https://abc-rc.pl/pl/products/przetwornica-dc-dc-mp1584en-max-3a-5v-micro-2-gramy-step-down-do-fpv-19861.html) | 4.90 | 307 | page |
| SparkFun BabyBuck 5 V 3 A, 6–32 V in | Botland | 35.90 | in stock | page |
| Pololu D24V22F5, 5 V 2.5 A | [Botland](https://botland.com.pl/przetwornice-step-down/4978-d24v22f5-przetwornica-step-down-5v-25a-pololu-2858-5904422365769.html) | 82.90 | 103 | page |
| INA219 current/voltage monitor | [MSX](https://sklep.msalamon.pl/produkt/ina219_mod/) | 10.99 | 33 | page |
| Littelfuse RUEF300 resettable fuse, 3 A hold, 30 V (min. 5 pcs) | [TME](https://www.tme.eu/pl/details/ruef300/bezpieczniki-polimerowe-tht/littelfuse/rf2611-000/) | 3.32 each | 1,194 | page |
| 3 × 18650 holder with leads | [Botland](https://botland.com.pl/koszyki-na-baterie/5241-koszyk-na-3-akumulatory-typu-18650-5904422374358.html) | 5.90 | 190 | page |
| 3S BMS 40 A with balancing | [ABC-RC](https://abc-rc.pl/pl/products/modul-bms-pcm-pcb-3s-12-6v-40a-wer-balance-ladowania-i-ochrony-ogniw-li-ion-do-ogniw-18650-11923.html) | 9.90 | 181 | page |
| IP2368 3S USB-C charge/discharge module, 100 W | [MSX](https://sklep.msalamon.pl/produkt/modul-szybkiego-ladowania-ip2368-100w-3s/) | 38.39 | 19 | page |
| Samsung INR18650-35E 3400 mAh cell (unprotected) | [Botland](https://botland.com.pl/akumulatory-li-ion/15216-ogniwo-18650-li-ion-samsung-inr18650-35e-3400mah-5904422343071.html) | 29.90 | 14 | page |

## Mounting

| Item | Shop | PLN | Stock | Checked |
|---|---|---|---|---|
| 1/4" tripod screw | [Gotronik](https://www.gotronik.pl/sruba-statywowa-gwint-14-fotograficzna-14-cala-165-x-8-x-5-mm-p-13875.html) | 7.45 | ships in 24 h | page |
| M3 brass insert for plastic, Bossard BN 1054 (min. 10) | [TME](https://www.tme.eu/pl/details/b3_bn1054/wkladki-gwintowane/bossard/1386743/) | 0.65 each | 37,600 | page |
| Tripod 150 cm, aluminium | Allegro via [Ceneo](https://www.ceneo.pl/142200273) | 74.99 | — | snippet |

## EU alternatives for the antenna and the motors (checked 2026-11-12)

Evidence: `papers/antennas/eu-sourcing/EXTRACTS.md` and `papers/drivetrain/eu-sourcing/EXTRACTS.md`. "Confirmed" means the shop's own product page was opened.

Antenna, small 2.4 GHz patch:

| Shop | Product | Size | Price | Status |
|---|---|---|---|---|
| [Rotorama](https://www.rotorama.com/product/maple-wireless-2-4g-9dbi-smerova-antena) (CZ) | Maple 9 dBi, RP-SMA | 90 × 80 × 10 mm | €13,19 | confirmed, in stock |
| [DIPOL](https://www.dipolnet.com/wlan_wi-fi_panel_antenna_atk-p1-2_4_ghz_8_db_3_m_cable_sma-rp_plug_A7132.htm) (PL) | ATK-P1 8 dBi panel, fixed 3 m cable, RP-SMA plug | 120 × 120 × 20 mm | €19,75 | confirmed, in stock; larger than the cradle |
| ht-dron (PL) | Maple 9 dBi, SMA | 90 × 80 × 10 mm | 73,00 zł | confirmed, out of stock |
| hobbydrone.cz (CZ) | Maple 9 dBi, both connectors | 90 × 80 × 10 mm | €13,30 | confirmed, sold out |
| [WiMo](https://www.wimo.com/de/vp165-24) (DE) | VP-165/24, 9 dBi | 92 × 100 × 30 mm (snippet) | unknown | unconfirmed, page blocked |

No patch of the Maple's size was found in stock at a Polish shop.

Gimbal motors:

| Shop | Product | Price | Status |
|---|---|---|---|
| [iFlight Europe](https://iflight-rc.eu/products/ipower-gm3506-gimbal-motor-w-encoder) (AT) | GM3506 with AS5048A | €50,90 (snippet) | unconfirmed, product page blocked; snippet said 45 in stock |
| [OpenELAB](https://openelab.io/pl/products/iflight-gm3506-hollow-gimbal-motor) | GM3506 with AS5048A | €52,45 | confirmed in stock; may ship from China, origin not shown |
| Opencircuit (NL) | SparkFun ROB-27478, 40 × 23 mm, with AS5048A | €74,95 | confirmed, 5–7 working days from an external warehouse |
| Kiwi Electronics (NL) | SparkFun ROB-20441, no encoder, no specs on the page | €54,11 | confirmed, 11 in stock; not shown to be suitable |

No gimbal motor was found in stock at a Polish shop. Encoder boards alone are available in Poland (AS5600: Gotronik 29,00 zł, Botland 29,90 zł), but no diametric magnet was found there.
