asdfgh0318/RadioMicroscope/papers/antennas/eu-sourcing/EXTRACTS.md

# EU sourcing extracts, fetched 2026-11-12 (curl, shops' own product pages)
Each quote is verbatim from the page text saved in the file named in brackets.

## IN STOCK

### DIPOL (Poland) dipolnet.com - ATK-P1/2.4 GHz panel, 8 dBi  [dipolnet_ATK-P1_A7132.txt]
URL: https://www.dipolnet.com/wlan_wi-fi_panel_antenna_atk-p1-2_4_ghz_8_db_3_m_cable_sma-rp_plug_A7132.htm
- "WLAN Wi-Fi Panel Antenna: ATK-P1/2.4 GHz (8 dB, 3 m cable & SMA/RP plug)"
- "€19.75" ; "Available" ; "100% Availability  We offer products available from our stock." (page JSON-LD: schema.org/InStock)
- "Band: 2400-2480 MHz  Gain: 8 dBi ... Directional antenna  3 m cable  Connector SMA R/P"
- "Radiation angle ... H/V° 70/70" ; "Polarization H,V" ; "Dimensions mm 120 × 120 × 20" ; "Weight kg 0.3"
- NOTE: slightly over the 100x100x25 limit and 0.3 kg including 3 m cable.

### Rotorama (Czech Republic) - Maple Wireless 2.4G 9dBi Patch  [rotorama_Maple_2.4G_9dBi_RP-SMA.txt]
URL: https://www.rotorama.com/product/maple-wireless-2-4g-9dbi-smerova-antena
- "In Stock" ; "€ 13,19" ; "Gain: 9dBi" ; "Conector: RP-SMA" ; "Polarization: Linear, vertical"
- "Size: 90x80x10mm" ; "Weight: 33g" ; "1x RP-SMA male/male adapter"

### Getic SIA (Latvia) - Alfa APA-M04, 7 dBi  [getic_Alfa_APA-M04_7dBi_TOO-BIG.txt]
URL: https://getic.com/product/alfa-panel-indoor-antenna-apa-m04
- "9.72 € ... In stock" ; "7 dBi gain" ; "RP-SMA Male" ; "Linear, vertical polarization"
- "Dimensions 173 x 145 x 61 mm" -> TOO BIG for this use.

## OUT OF STOCK (confirmed on shop page)
- ht-dron.pl SMA version https://www.ht-dron.pl/Maple-Wireless-2-4GHz-9dBi-Directional-SMA-Antenna-for-Extended-Range-p9290/s_lang/en : page JSON-LD "availability": "http://schema.org/OutOfStock", "price":73 (PLN)  [OUT-OF-STOCK_ht-dron.pl_Maple_SMA.txt]
- hobbydrone.cz RP-SMA https://hobbydrone.cz/en/2-4g-9dbi-directional-antenna-rp-sma : "13,30 €" "Currently unavailable" "The item has been sold out..." "Size: 90*80*10mm Weight: 17g Antenna Polarization: Linear polarization"
- hobbydrone.cz SMA-male https://hobbydrone.cz/en/2-4g-9dbi-directional-antenna-sma-male : same text, "Currently unavailable"
- rlx.sk (Seeed 8 dBi true-SMA patch) https://rlx.sk/sk/accessories-ipod/5232-directional-patch-24ghz-sma-articulated-antenna-seeed-318020070.html : "OUT OF STOCK"
