asdfgh0318/RadioMicroscope/papers/drivetrain/eu-sourcing/EXTRACTS.md

# EU/PL sourcing extracts - fetched 2026-11-12

Each quote is verbatim from the saved file named in brackets (fetched with curl from the shop's own product page).

## Botland (PL) - Grove AS5600 encoder [botland-grove-as5600.txt]
URL: https://botland.com.pl/grove-enkodery-i-potencjometry/15546-grove-enkoder-magnetyczny-12-bit-as5600-seeedstudio-101020692-5904422351878.html
> "priceCurrency": "PLN", "price": "29.90", ... "availability": "https://schema.org/InStock", "sku": "SEE-15546"
> Moduł wyposażony w enkoder magnetyczny AS5600 o rozdzielczości 12-bit. ... Pracuje z napięciem 3,3 V lub 5 V.

## Botland (PL) - magnet 6x3 mm x5 [botland-magnet-6x3.txt]  -- NOT IN STOCK
URL: https://botland.com.pl/magnesy-neodymowe/6504-magnes-neodymowy-okragly-6x3mm-5szt-5904422375119.html
> "priceCurrency": "PLN", "price": "5.90", ... "availability": "https://schema.org/BackOrder", "sku": "MAG-06504"
> Magnes neodymowy okrągły o wymiarach 6 x 3 mm. ... Cena za 5 sztuk.   (page does not say diametric magnetisation)

## Gotronik (PL) - AS5600 module [gotronik-as5600.txt / .pdf]
URL: https://www.gotronik.pl/modul-magnetycznego-enkodera-as5600-bezkontaktowy-czujnik-kata-obrotu-kartapdf-12903.html
(the shop serves its product sheet as a PDF; header "Dane aktualne na dzień: 12-11-2026 15:17")
> Cena brutto  29,00 zł
> Czas wysyłki  24 godziny
> napięcie zasilania: 3,3V ... interfejsy: magistrala I²C, PWM, sygnał analogowy ... rozdzielczość pomiaru: 12 bit ... wymiary: 33mm × 33mm
No explicit stock count; "Czas wysyłki 24 godziny" is the shop's in-stock shipping time.

## OpenELAB (shop is non-EU-based; EUR, shows Polish locale) - iFlight GM3506 with AS5048A [openelab-gm3506-encoder.txt]
URL: https://openelab.io/pl/products/iflight-gm3506-hollow-gimbal-motor
> "availability": "http://schema.org/InStock", "price": "52.45", "priceCurrency": "EUR"
> konfigurację silnika 24N/22P ... moment obciążenia 600–1000 g.cm ... pracę pod obciążeniem przy 12 V / 1 A
> wał drążony o podanej średnicy zewnętrznej 12 mm i średnicy wewnętrznej 8,6 mm
> 25,8 +/-0,2 mm wysokości silnika i 72 +/-0,2 g masy silnika
> Potwierdzono, że zestaw zawiera zarówno silnik gimbala iPower GM3506, jak i enkoder AS5048A z aluminiową obudową.
> "Import customs clearance and VAT are fully handled by us."
Site banner (not product-specific): "The SKUs and quantities listed below are currently out of stock. They must be sourced from our China warehouse and will ship from China once ready."
-> shipping origin for this SKU NOT shown on the page (return centres: US, Germany or China). Treat as "listed InStock, origin unverified". Phase resistance not on page.

## Kiwi Electronics (NL) - SparkFun gimbal motor ROB-20441 [kiwi-gimbal-motor.txt]
URL: https://www.kiwi-electronics.com/en/three-phase-brushless-gimbal-stabilizer-motor-11295
> "price": "54.11", "availability": "http://schema.org/InStock"
> € 54.11 / € 43.99 Ex. VAT / 11 piece(s) in stock
> Fast shipping from The Netherlands  (the page lists Poland among destinations)
> Product Code SF-ROB-20441 ; EM3215 3-Phase Brushless DC Motor Datasheet
No diameter, resistance, poles or encoder given on page; no encoder.

## Opencircuit (NL) - SparkFun gimbal motor with AS5048A, ROB-27478 [opencircuit-sparkfun-gimbal-encoder.txt]  -- NOT IN STOCK
URL: https://opencircuit.nl/product/gimbal-motor-with-encoder-12v-467rpm
> € 74,95 / € 61,95 Excl. BTW (NL)  In extern magazijn  Levertijd 5 tot 7 werkdagen  Voorraad alert instellen
> compacte formaat van 40x20 mm ... geïntegreerde AS5048A encoder ... Hoogte 23 mm

## Opencircuit (NL) - SparkFun gimbal motor no encoder, ROB-27477 [opencircuit-sparkfun-gimbal-noenc.txt]  -- NOT IN STOCK
URL: https://opencircuit.nl/product/gimbal-motor-w-o-encoder-12v-467rpm
> € 53,20 / € 43,95 Excl. BTW (NL)  In extern magazijn  Levertijd 5 tot 7 werkdagen
> compacte 40x16mm afmeting ... 467 RPM ... 58,3 g

## BerryBase (DE) - SparkFun BLDC gimbal motor [berrybase-sparkfun-bldc-gimbal-SOLDOUT.txt]  -- SOLD OUT
URL: https://www.berrybase.de/sparkfun-bldc-gimbal-motor-7.4v-2000rpm-8-magnetpole-3-phasen-320gcm-drehmoment-6-8v
> "availability": "https://schema.org/SoldOut" ... "price": 53.5

## NOT retrieved at the product page (blocked, HTTP 429 / 403)
iflight-rc.eu product pages (429 on every /products/ URL, from curl and WebFetch; search/home pages returned 200), upgraderc.be/.com (429), rcdrone.top (429/403),
robotshop.com (403), kamami.pl (403), tme.eu (403), tinytronics.nl (403), eckstein-shop.de (403), droneshop.nl (403), allegro.pl (403).
Search-page prices seen on iflight-rc.eu (listing grid, no stock status, NOT a product page): GM2804 €26.90, GM2804 w/ encoder €46.90, GM5208-12 €47.90, GM5208-12 w/ encoder €74.90, GM6208-150T €72.90 / w/ encoder €98.90.
