asdfgh0318/RadioMicroscope/cad/stl-longrange24/tub.stl

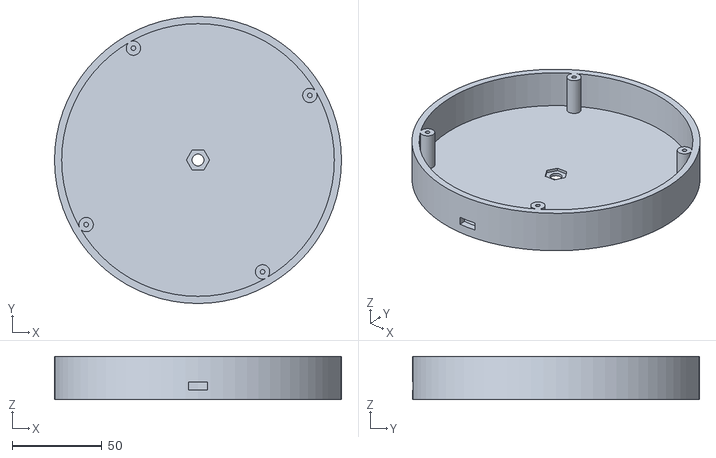
[picture p8: CAD file, 2026-11-12]
cad/stl-longrange24/tub.stl
160.0 x 160.0 x 24.0
