asdfgh0318/RadioMicroscope/cad/stl-palm58/yoke.stl

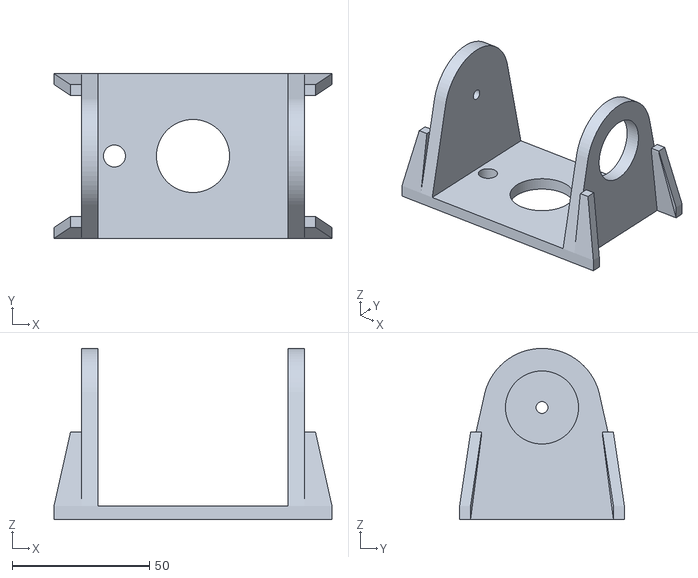
[picture p9: CAD file, 2026-11-12]
cad/stl-palm58/yoke.stl
101.2 x 60.0 x 62.3
