asdfgh0318/RadioMicroscope/cad/stl/lid.stl

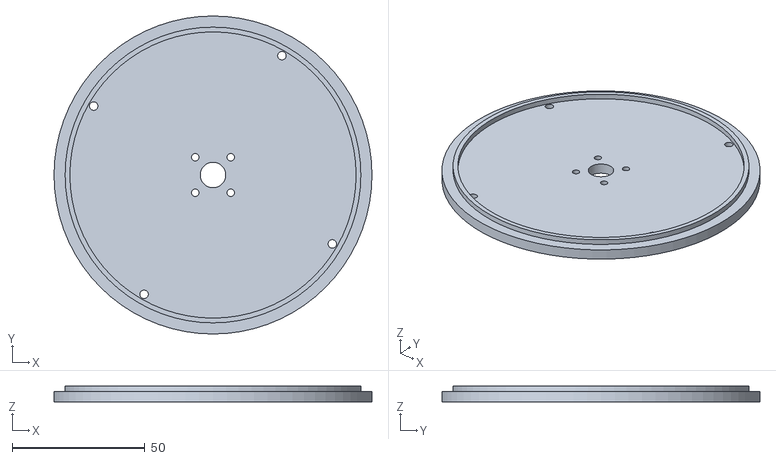
[picture p10: CAD file, 2026-11-12]
cad/stl/lid.stl
120.0 x 120.0 x 6.00
