asdfgh0318/RadioMicroscope/cad/stl-longrange24/yoke.stl

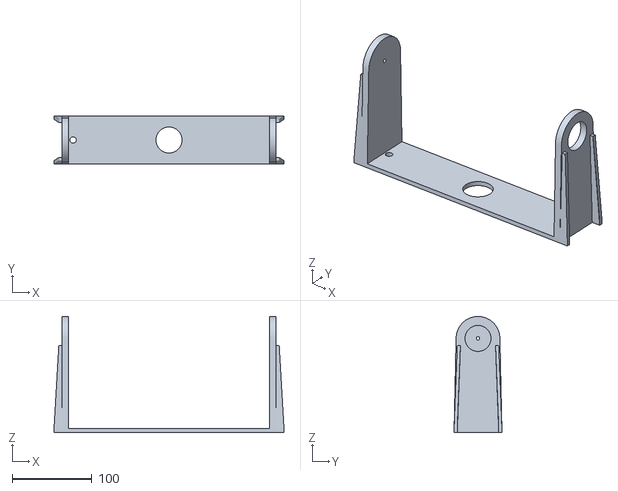
[picture p11: CAD file, 2026-11-12]
cad/stl-longrange24/yoke.stl
288.5 x 60.0 x 145.5
