asdfgh0318/RadioMicroscope/cad/stl-palm58/lid.stl

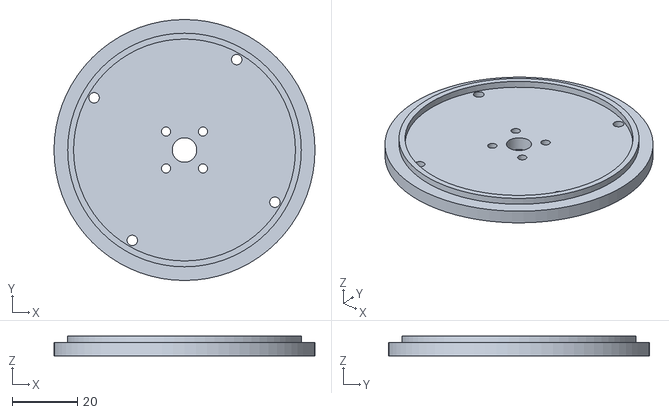
[picture p12: CAD file, 2026-11-12]
cad/stl-palm58/lid.stl
80.0 x 80.0 x 6.00
