asdfgh0318/RadioMicroscope/cad/stl/tub.stl

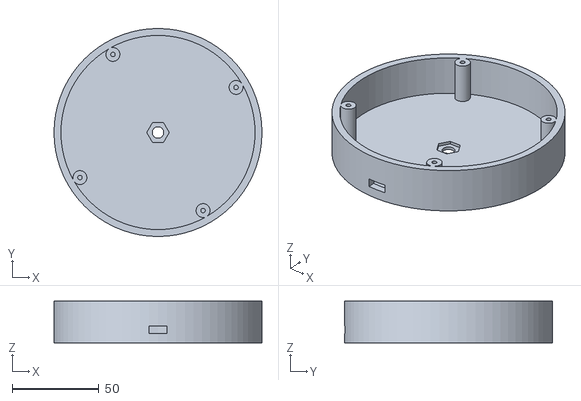
[picture p13: CAD file, 2026-11-12]
cad/stl/tub.stl
120.0 x 120.0 x 24.0
