asdfgh0318/RadioMicroscope/cad/stl-longrange24/cradle.stl

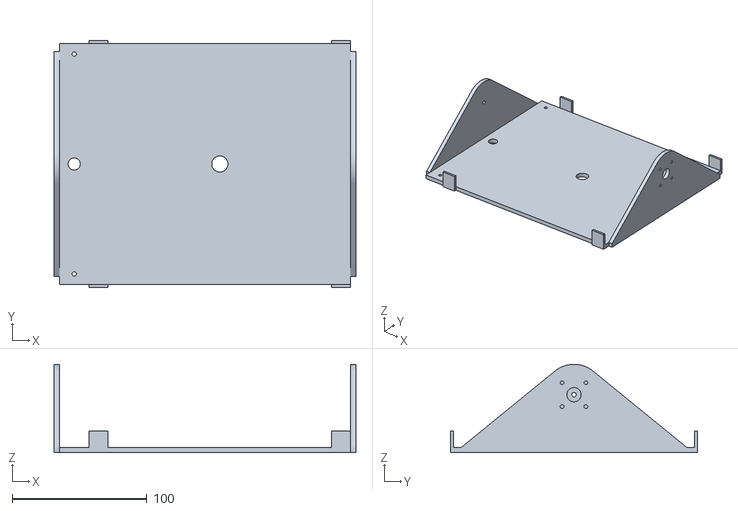
[picture p14: CAD file, 2026-11-12]
cad/stl-longrange24/cradle.stl
224.0 x 183.0 x 65.5
