asdfgh0318/RadioMicroscope/cad/stl-palm58/cradle.stl

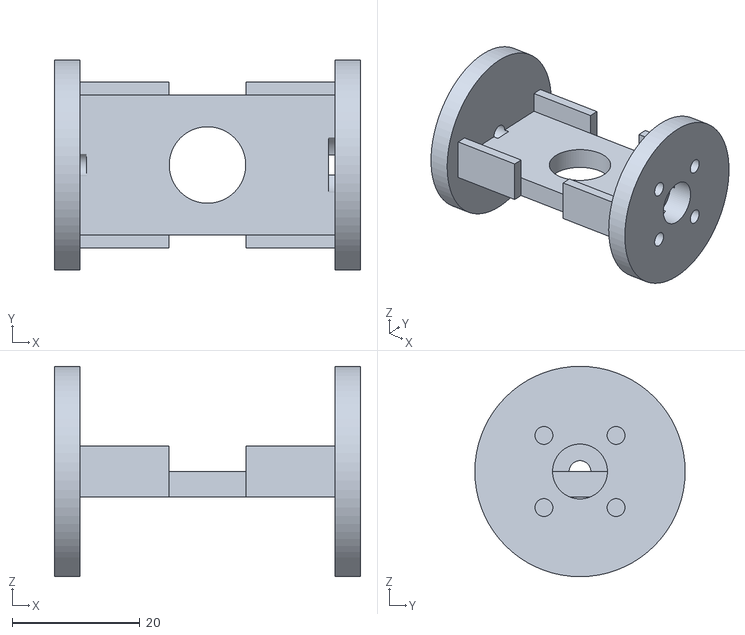
[picture p15: CAD file, 2026-11-12]
cad/stl-palm58/cradle.stl
48.0 x 33.0 x 33.0
