asdfgh0318/RadioMicroscope/cad/stl/yoke.stl

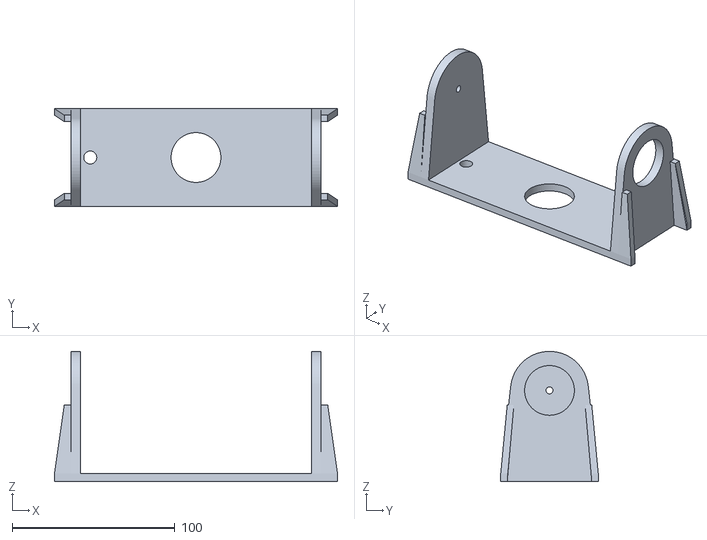
[picture p16: CAD file, 2026-11-12]
cad/stl/yoke.stl
174.0 x 60.0 x 80.1
