asdfgh0318/RadioMicroscope/cad/stl-longrange24/lid.stl

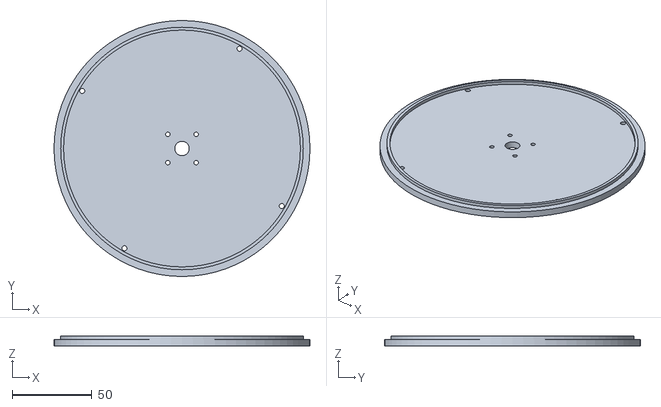
[picture p17: CAD file, 2026-11-12]
cad/stl-longrange24/lid.stl
160.0 x 160.0 x 6.00
