asdfgh0318/RadioMicroscope/cad/stl-palm58/grip.stl

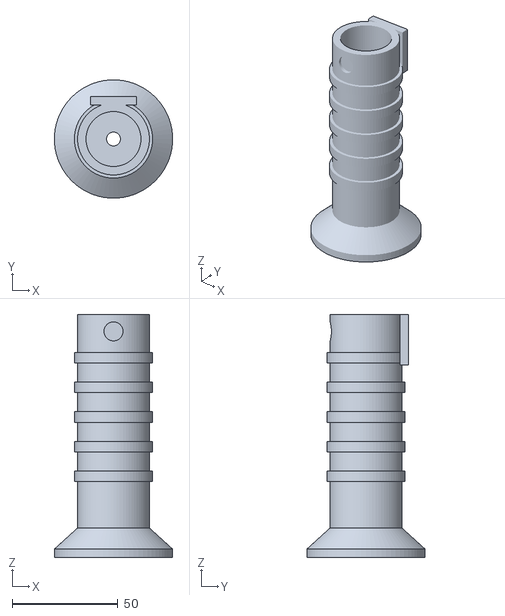
[picture p18: CAD file, 2026-11-12]
cad/stl-palm58/grip.stl
56.0 x 56.0 x 115.0
