asdfgh0318/RadioMicroscope/cad/stl/cradle.stl

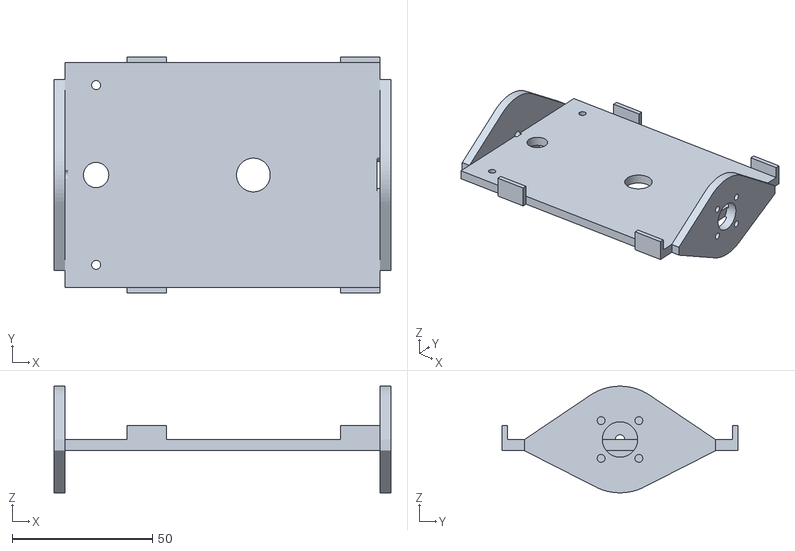
[picture p19: CAD file, 2026-11-12]
cad/stl/cradle.stl
120.0 x 84.0 x 38.0
