asdfgh0318/RadioMicroscope/cad/stl-palm58/tub.stl

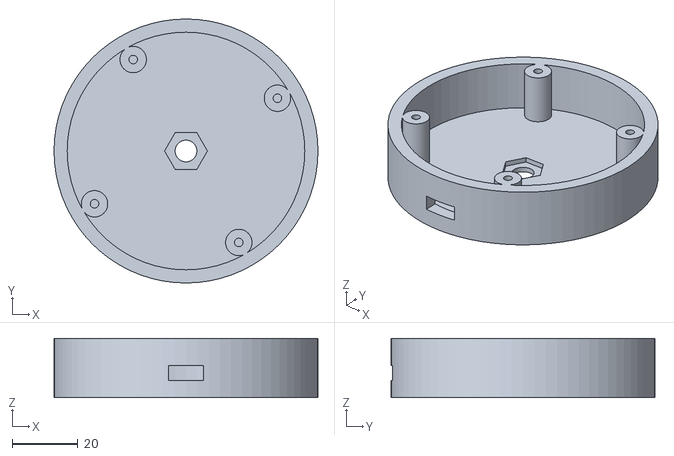
[picture p20: CAD file, 2026-11-12]
cad/stl-palm58/tub.stl
80.0 x 80.0 x 18.0
