asdfgh0318/RadioMicroscope/(commit log)

2026-03-09 Implement firmware core: WiFi AP, WebSocket, servo control, IMU, RSSI (closes #3)
2026-03-09 Implement web UI: dark theme control page with sliders, RSSI, IMU (closes #4)
2026-03-09 Add Arduino IDE sketch, fix variable shadowing, add .gitignore
    [RadioMicroscope.ino]
2026-03-09 Add README, prototype photos, set default azimuth trim to 500μs
    - README with hardware BOM, setup instructions (Arduino IDE + CLI), usage guide
    - Prototype and notebook photos in docs/
    - Default azimuth trim changed from 0 to 500μs (calibrated on hardware)
    - Trim range expanded to ±500μs
2026-11-12 Redesign as v2: brushless pan/tilt head, three-processor firmware, CAD, docs
    Move the v1 prototype to archive/v1 and start again from the brief in 1.md.
    - lib/RMCore: portable header-only core (sky map, scan pattern, step
    tracker, link protocol, NMEA, attitude, bearing-crossing locate) with
    133 PC checks in tests/
    - firmware/: sensor (XIAO ESP32-C5 sniffer), brain (XIAO ESP32-S3: modes,
    control page, camera, drivetrain and receiver options), motion (ESP32 +
    Simple FOC for two gimbal motors)
    - web/: control page, embedded into the brain firmware
    - cad/: parametric OpenSCAD model with desk, handheld 5.8 GHz and long
    range 2.4 GHz variants, printable STL files and a 3D viewer templat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
