asdfgh0318/RadioMicroscope/(notices)

Notices in the files:
papers/antennas/EXTRACTS.md:
- URLs: https://gitlab.com/api/v4/projects/kicad%2Flibraries%2Fkicad-footprints/repository/tree?path=RF_Antenna.pretty&per_page=100 ; https://gitlab.com/kicad/libraries/kicad-footprints/-/raw/master/LICENSE.md
